aadslingerland/HlgController/README.md

# HlgController
Arduino sketch and hardware design to control a Mean Well HLG dimmer with sunrise and sunset.
