aadslingerland/HlgController/(commit log)

2018-05-11 Small bug in P1 fixed and some documentation changes.
    [HlgController.ino]
2018-05-13 Relay on and off switched (as well as the wiring on the relay).
